StudentOrganisationForAerospaceResearch/AvionicsFlightBoard/AndromedaV2.pdf

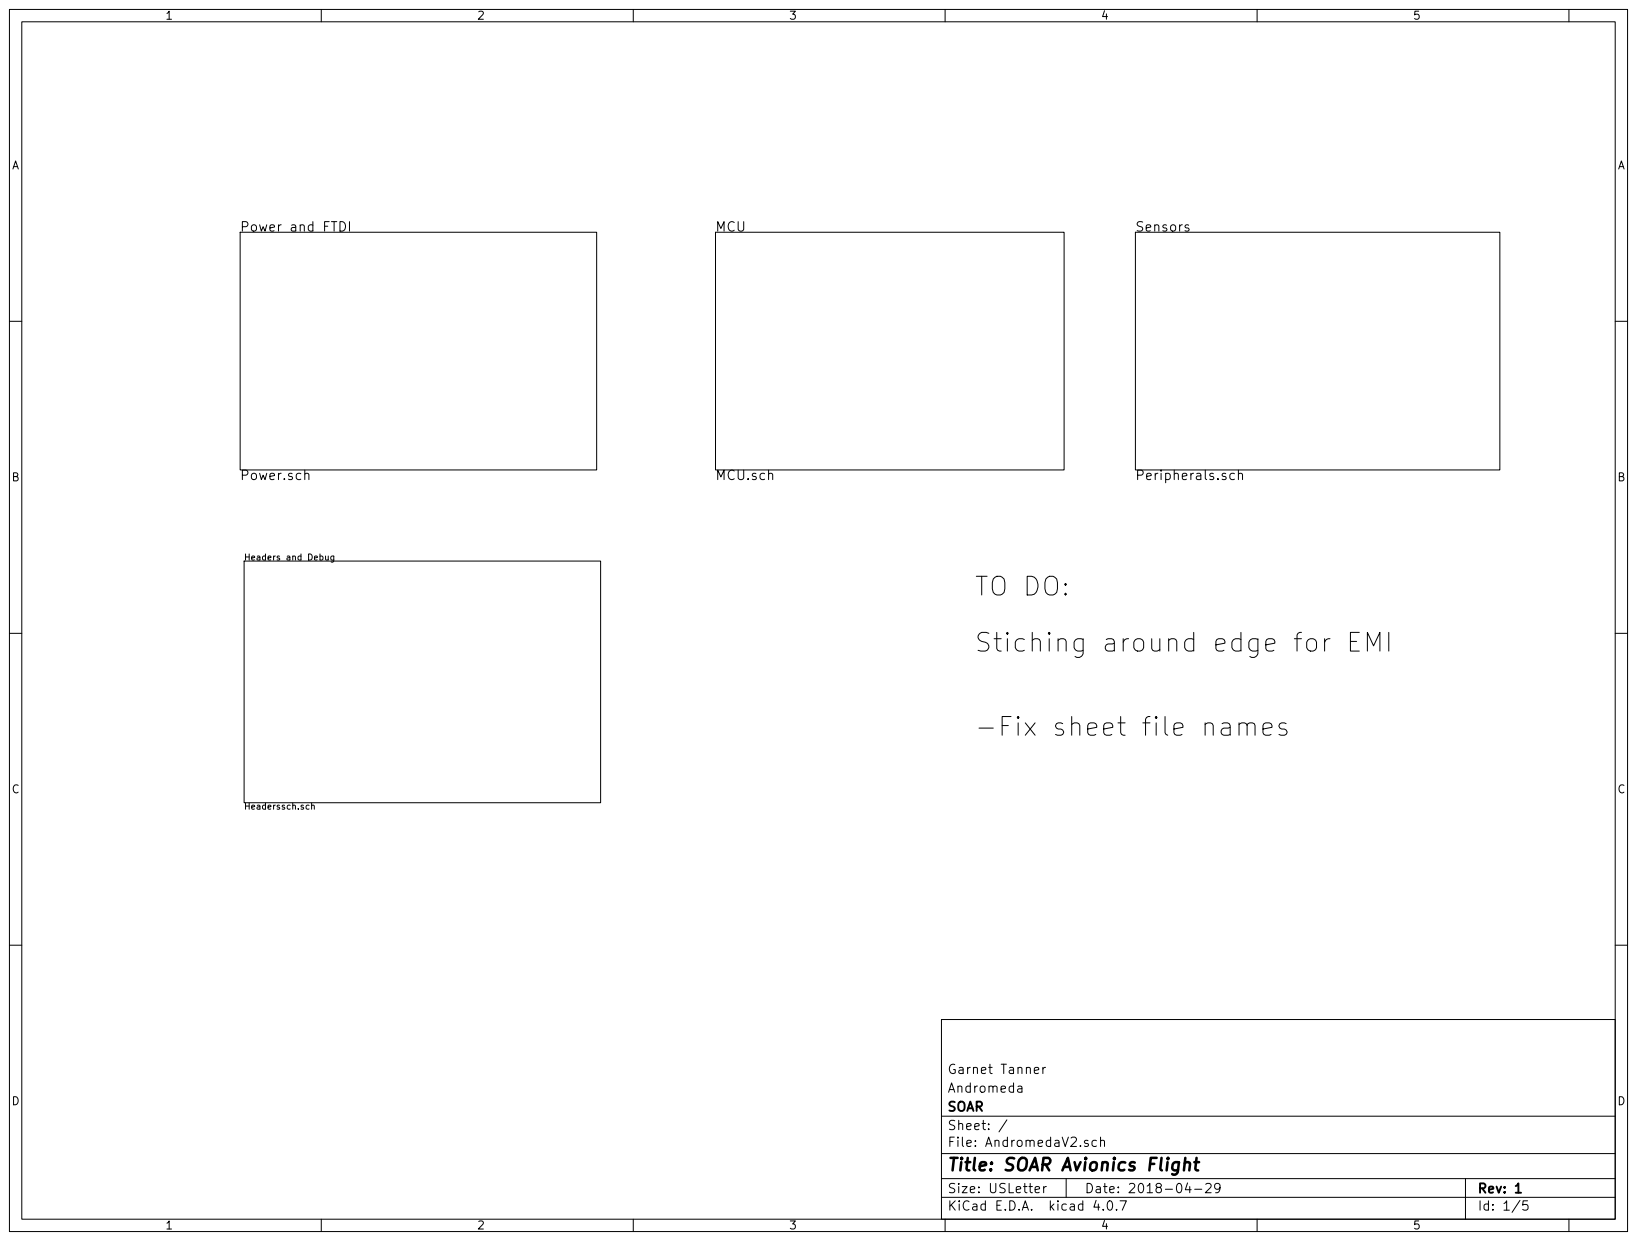
[picture p1: page 1]

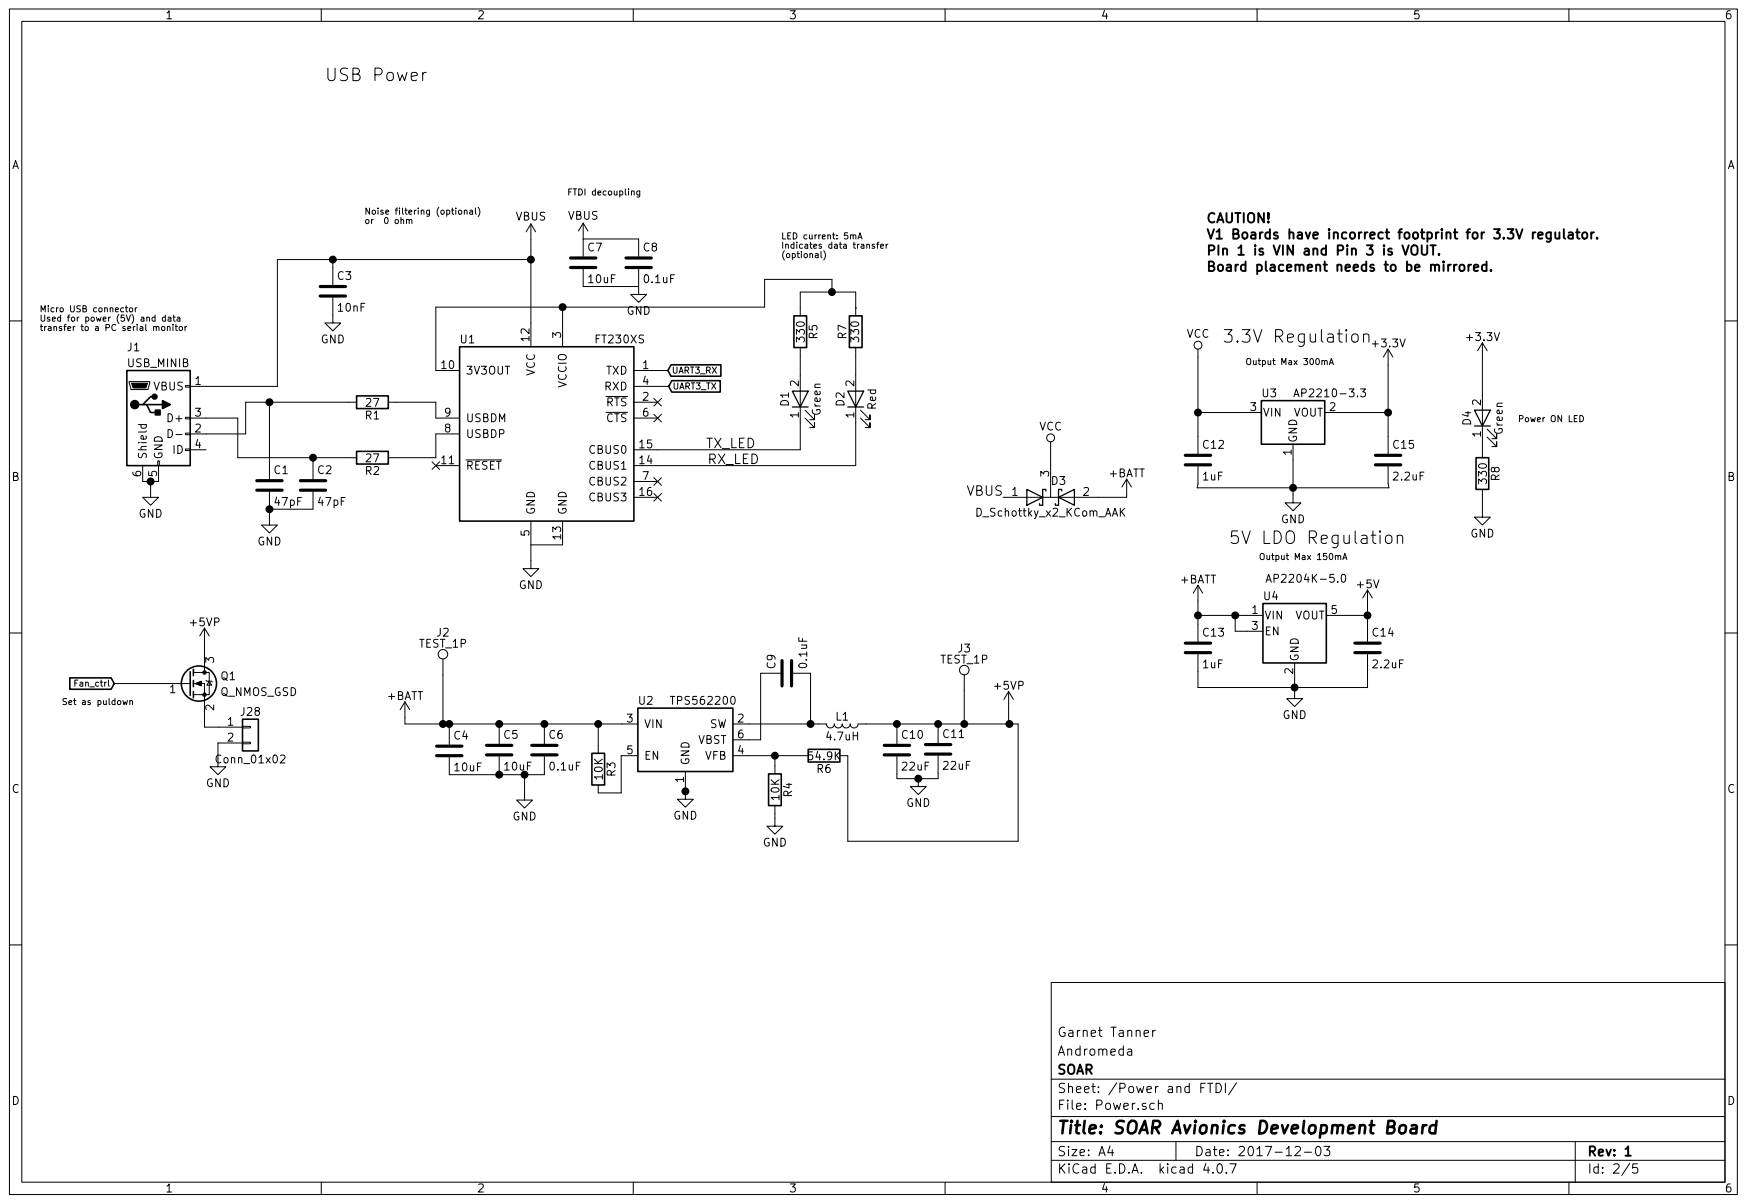
[picture p2: page 2]

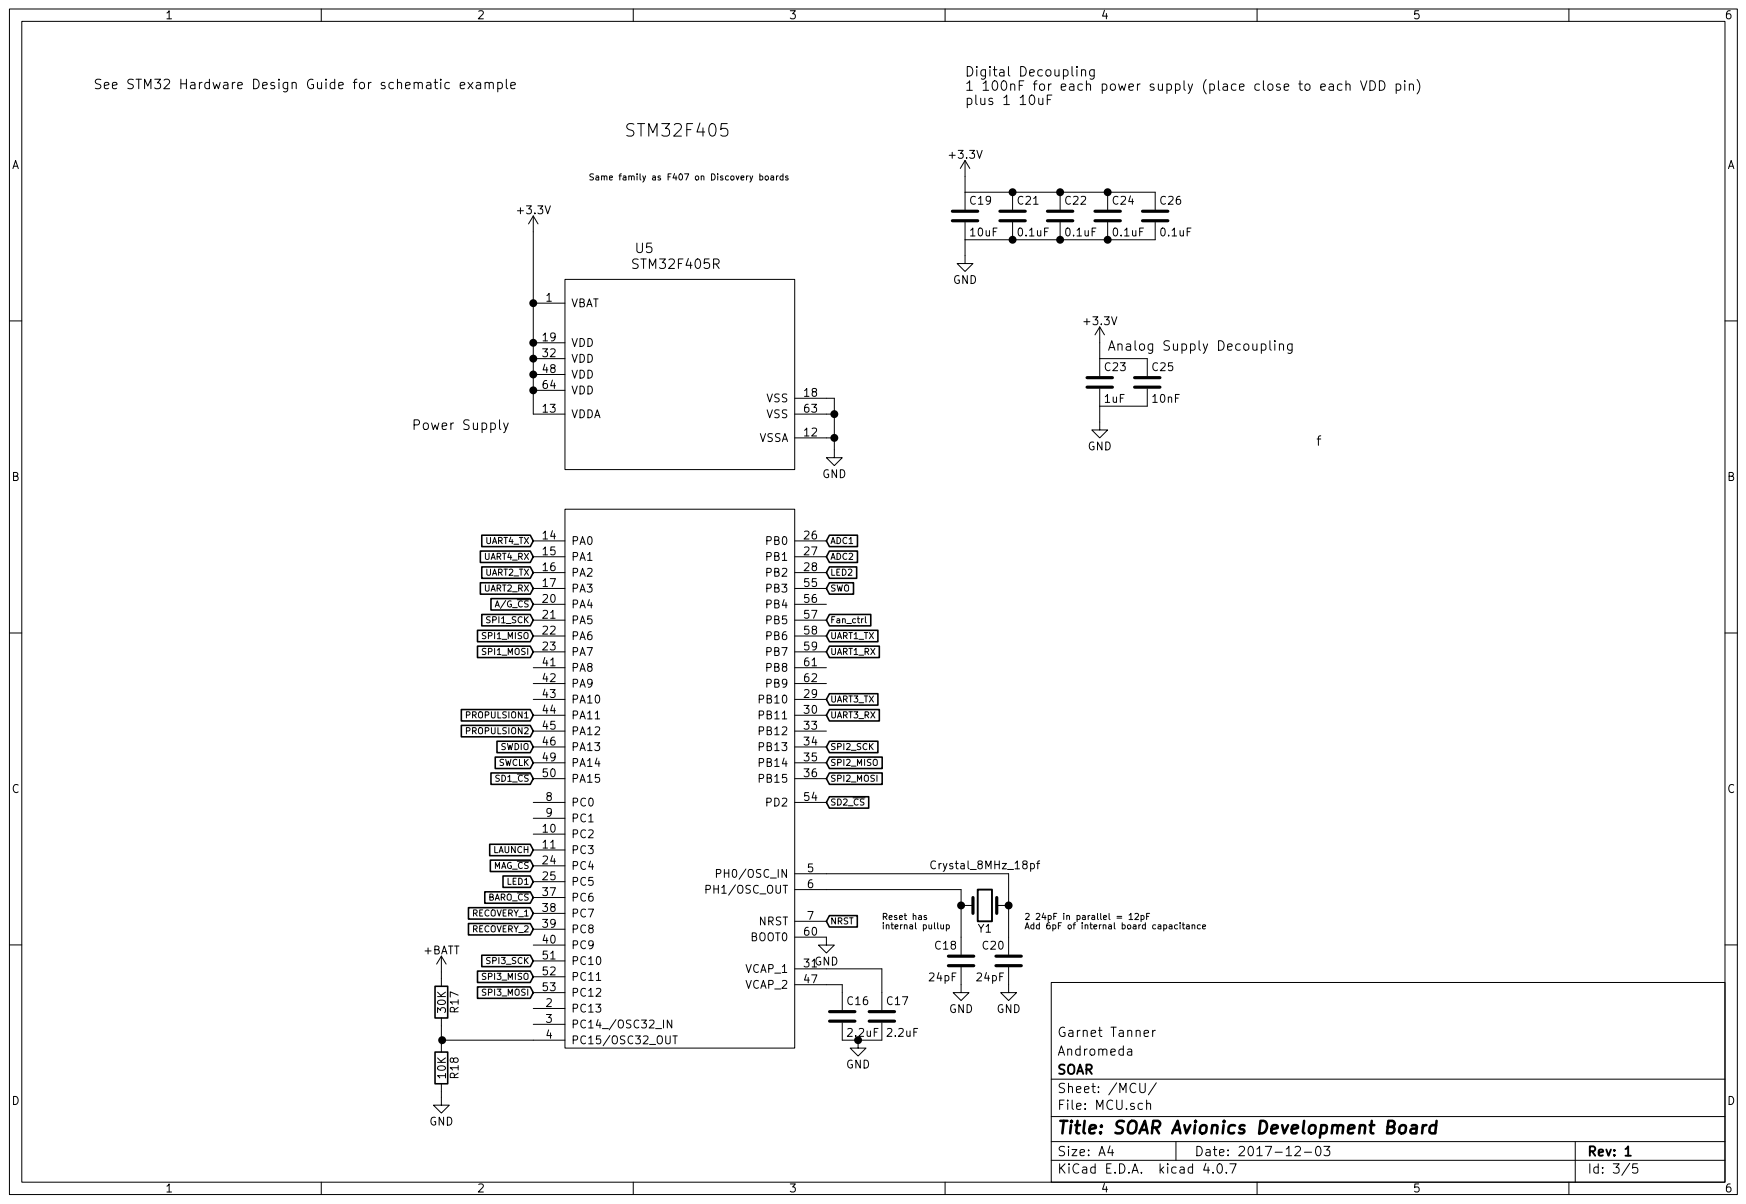
[picture p3: page 3]

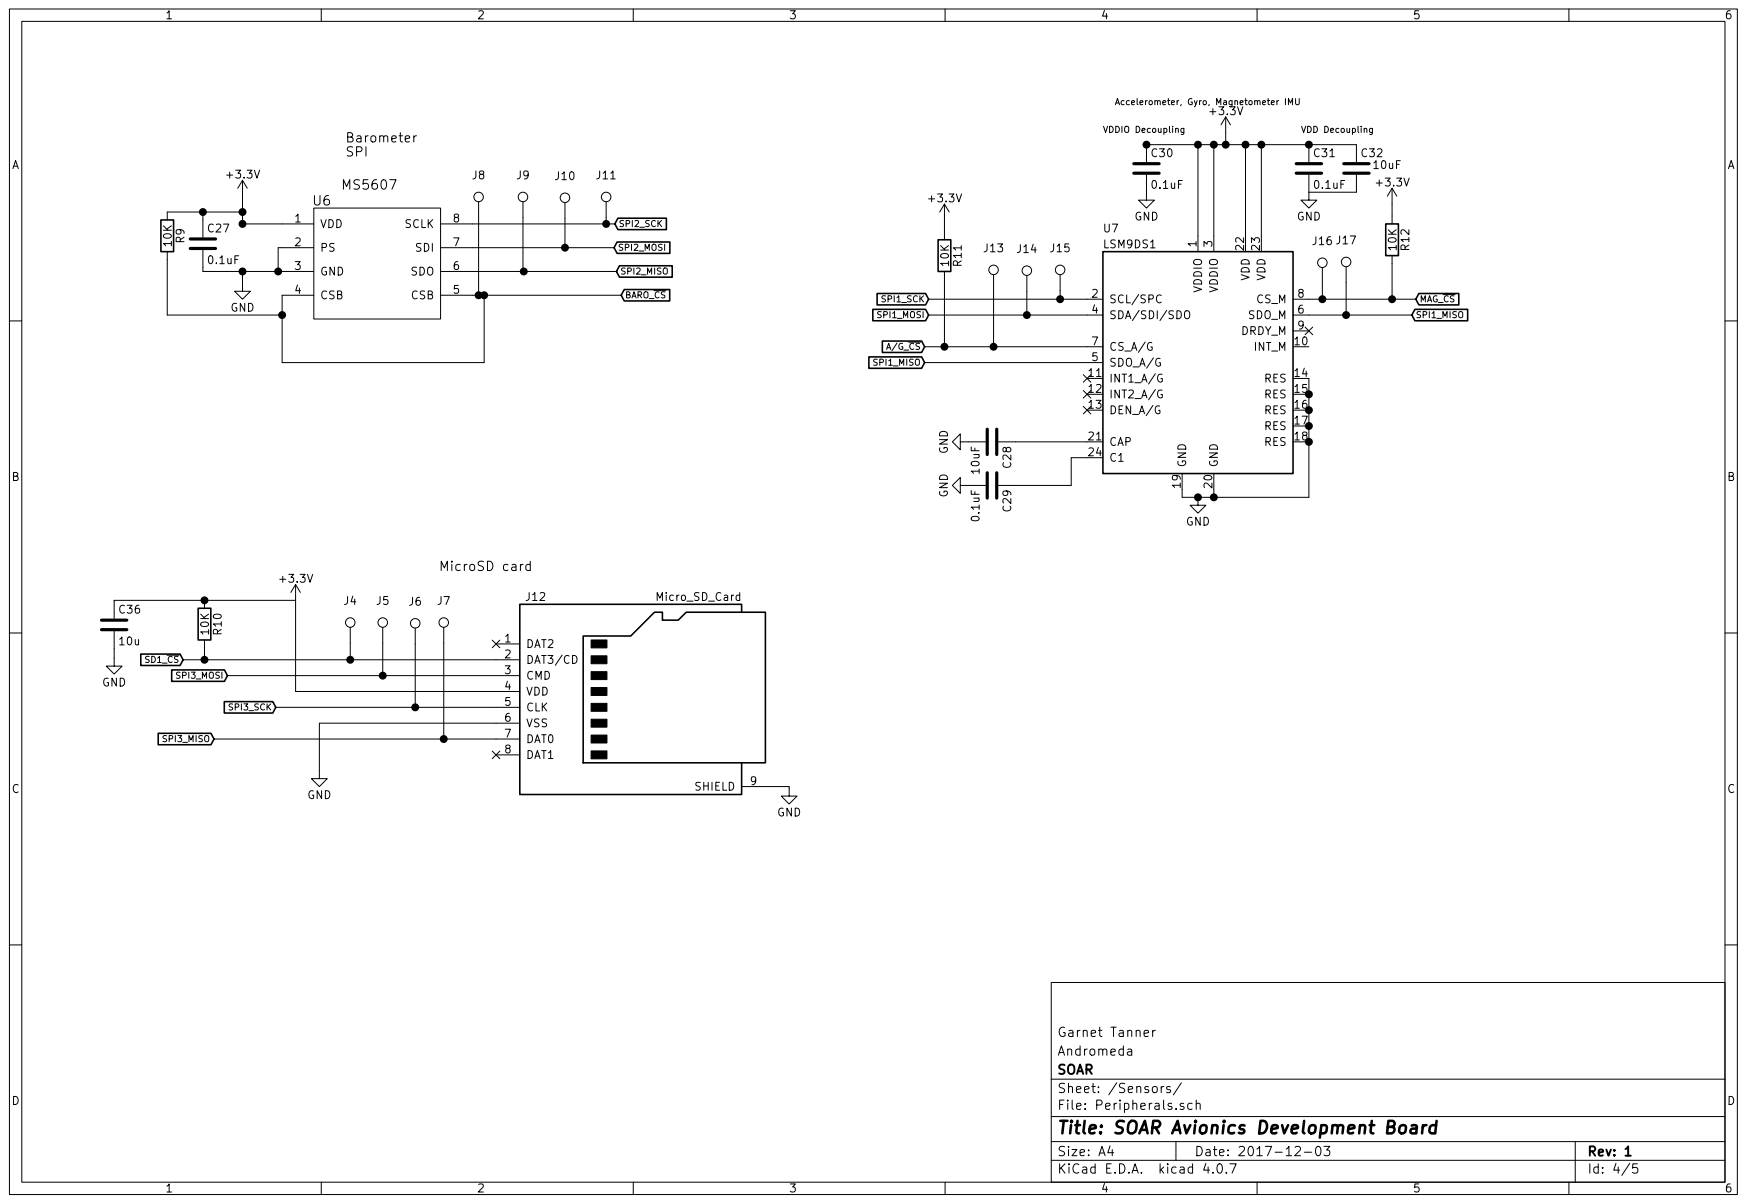
[picture p4: page 4]

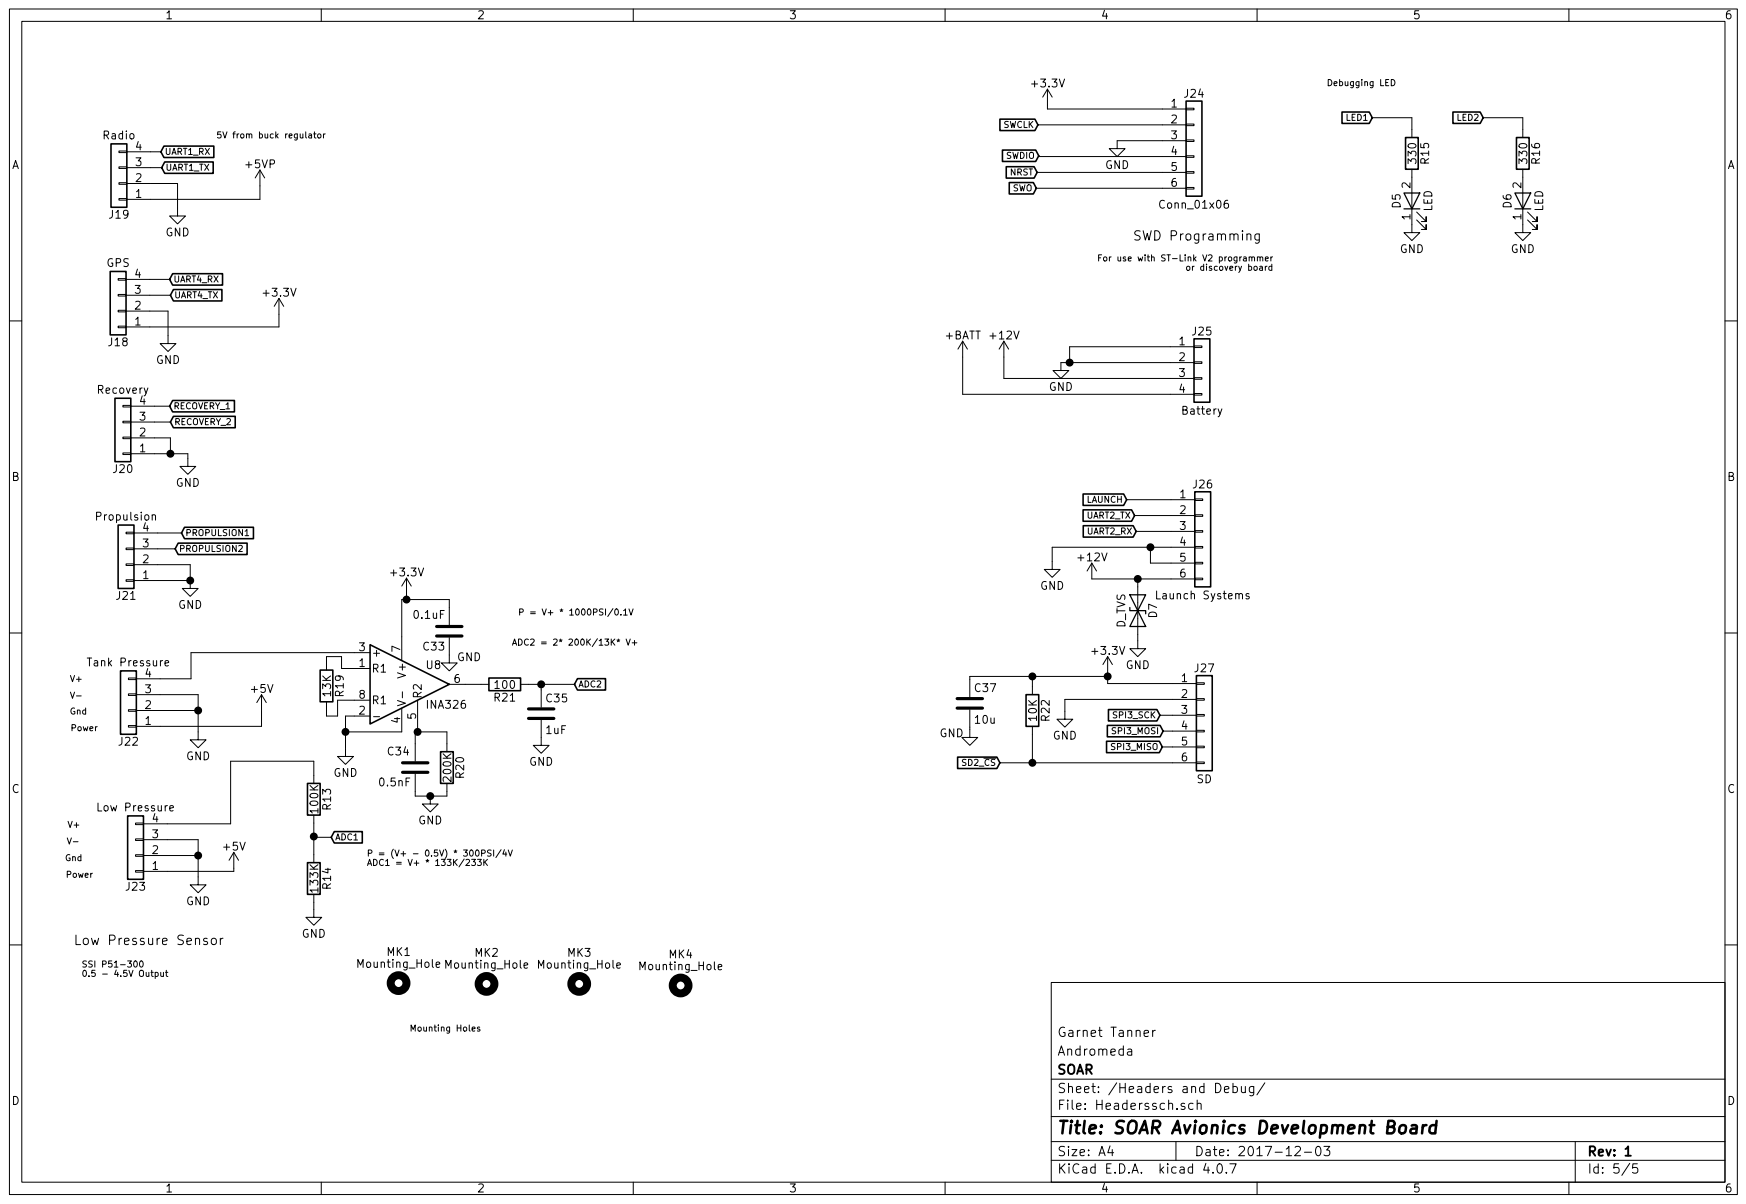
[picture p5: page 5]
