StudentOrganisationForAerospaceResearch/AvionicsFlightBoard/VanderAvionics.ioc

Mcu.UserName=STM32F405RGTx
PA0-WKUP.Signal=UART4_TX
PA1.Signal=UART4_RX
PA11.GPIO_Label=PROPULSION1
PA11.Signal=GPIO_Output
PA12.GPIO_Label=PROPULSION2
PA12.Signal=GPIO_Output
PA13.Signal=SYS_JTMS-SWDIO
PA14.Signal=SYS_JTCK-SWCLK
PA15.GPIO_Label=SD2_CS'
PA15.Signal=GPIO_Output
PA2.Signal=USART2_TX
PA3.Signal=USART2_RX
PA4.GPIO_Label=A/G_CS'
PA4.Signal=GPIO_Output
PA5.Signal=SPI1_SCK
PA6.Signal=SPI1_MISO
PA7.Signal=SPI1_MOSI
PB0.Signal=ADCx_IN8
PB1.Signal=ADCx_IN9
PB10.Signal=USART3_TX
PB11.Signal=USART3_RX
PB13.Signal=SPI2_SCK
PB14.Signal=SPI2_MISO
PB15.Signal=SPI2_MOSI
PB2.GPIO_Label=LED2
PB2.Signal=GPIO_Output
PB3.Signal=SYS_JTDO-SWO
PB6.Signal=USART1_TX
PB7.Signal=USART1_RX
PC10.Signal=SPI3_SCK
PC11.Signal=SPI3_MISO
PC12.Signal=SPI3_MOSI
PC3.GPIO_Label=Launch Systems
PC3.Signal=GPIO_Input
PC4.GPIO_Label=MAG_CS'
PC4.Signal=GPIO_Output
PC5.GPIO_Label=LED1
PC5.Signal=GPIO_Output
PC6.GPIO_Label=Baro_CS'
PC6.Signal=GPIO_Output
PC7.GPIO_Label=RECOVERY1
PC7.Signal=GPIO_Output
PC8.GPIO_Label=RECOVERY2
PC8.Signal=GPIO_Output
PD2.GPIO_Label=SD2_CS'
PD2.Signal=GPIO_Output
PH0-OSC_IN.Signal=RCC_OSC_IN
PH1-OSC_OUT.Signal=RCC_OSC_OUT
