StudentOrganisationForAerospaceResearch/AvionicsFlightBoard/(commit log)

2018-04-29 initial project commit
    [AndromedaV2.kicad_pcb, AndromedaV2.sch, Headerssch.sch, MCU.sch, Peripherals.sch, Power.sch]
2018-04-29 Add schematic PDF
2018-05-05 add Terminal Block 5mm
2018-05-07 further work on schematic and PCB
    [AndromedaV2.kicad_pcb, AndromedaV2.sch]
2018-05-08 Bring schematic in line with PCB. Previous update broke this.
    [AndromedaV2.kicad_pcb, Headerssch.sch, MCU.sch, Peripherals.sch, Power.sch]
2018-05-08 Add schem documentation and generate new PDF
    [AndromedaV2.sch, Headerssch.sch]
2018-05-11 Changes based on review reccommemdations
    [AndromedaV2.kicad_pcb, AndromedaV2.sch, Headerssch.sch, MCU.sch, Peripherals.sch, Power.sch]
2018-05-17 Final design published. Gerbers and PDF schematic generated
    [AndromedaV2.kicad_pcb, Headerssch.sch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]
